mikevang/Pi-tmaster-Improved/(commit log)

2026-10-15 Initial improvements. Change to Thermistor probes. Connect to local Wifi. Add web server with probe temps and rolling graph
2026-10-15 Update schematic and ReadMe
2026-10-16 Fix endless loop if no WiFi at startup
    [Pi-tmaster-improved.ino]
2026-10-21 Fix history endpoint url. Fix bad write to flash if clock arrives just before saving. Add more debug info to page status. Move I2C initialization forward in setup.
    [Pi-tmaster-improved.ino]
